pcpackrat/esp32-eth01-voter/docs/es8311.png

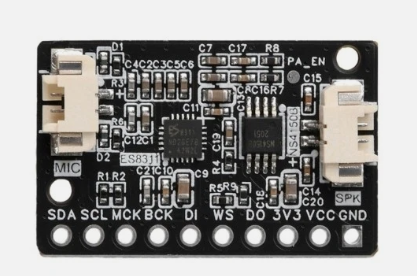
docs/es8311.png
