pcpackrat/esp32-eth01-voter/docs/cdm1250.jpg

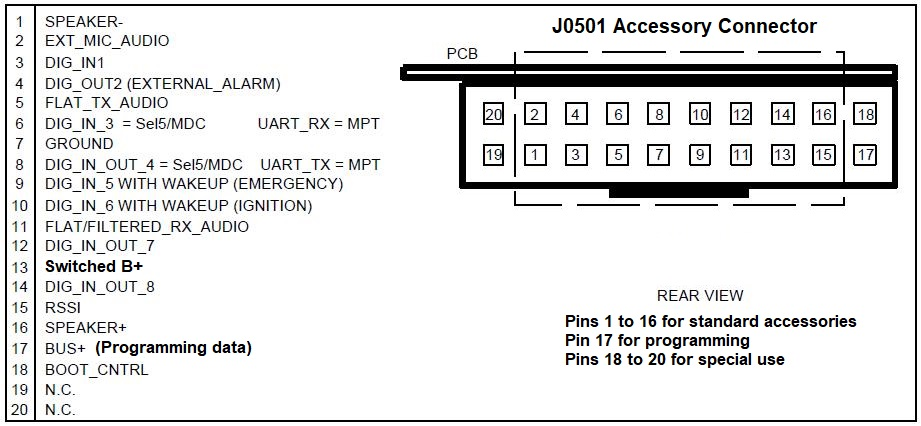
docs/cdm1250.jpg
