pcpackrat/esp32-eth01-voter/docs/GPS-Schematic.png

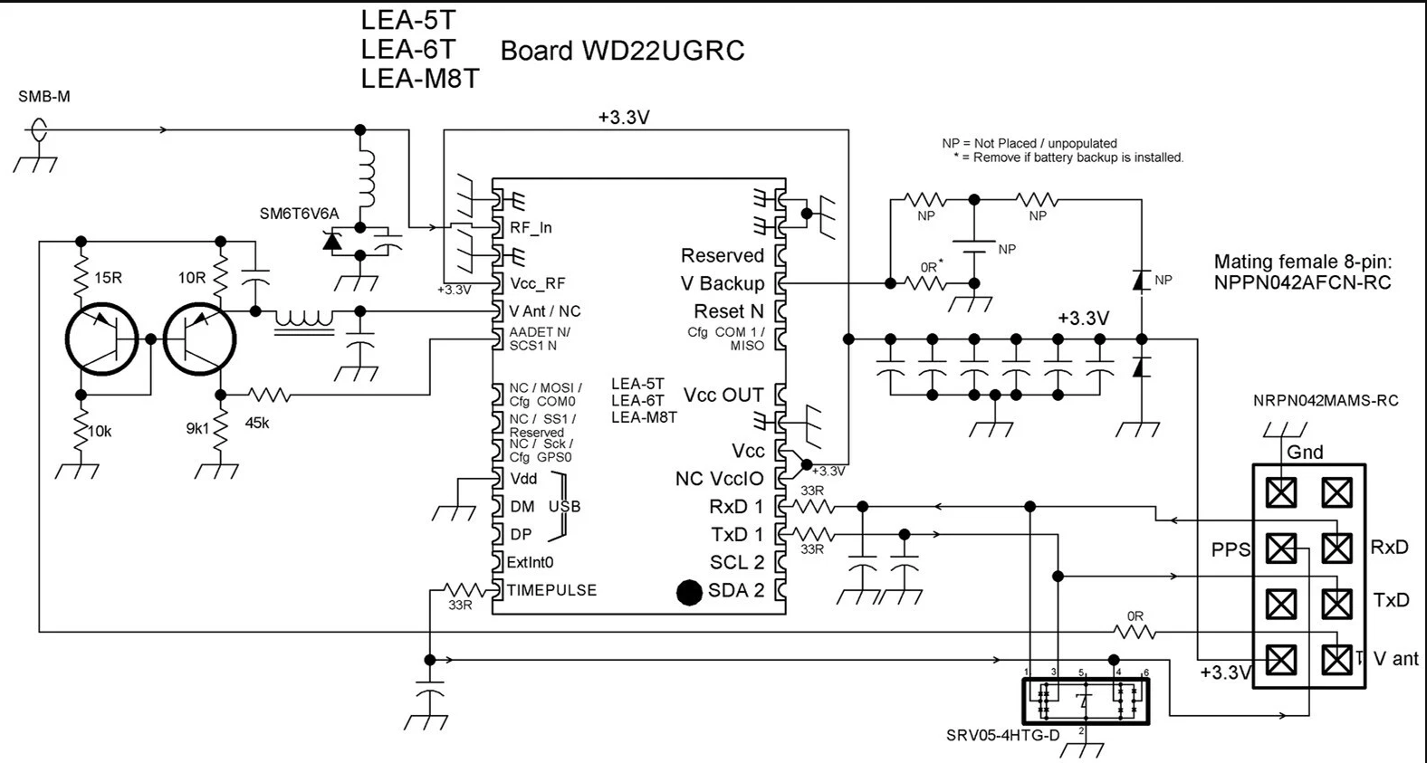
docs/GPS-Schematic.png
