pcpackrat/esp32-eth01-voter/docs/ESP32-ETH01_case.3mf

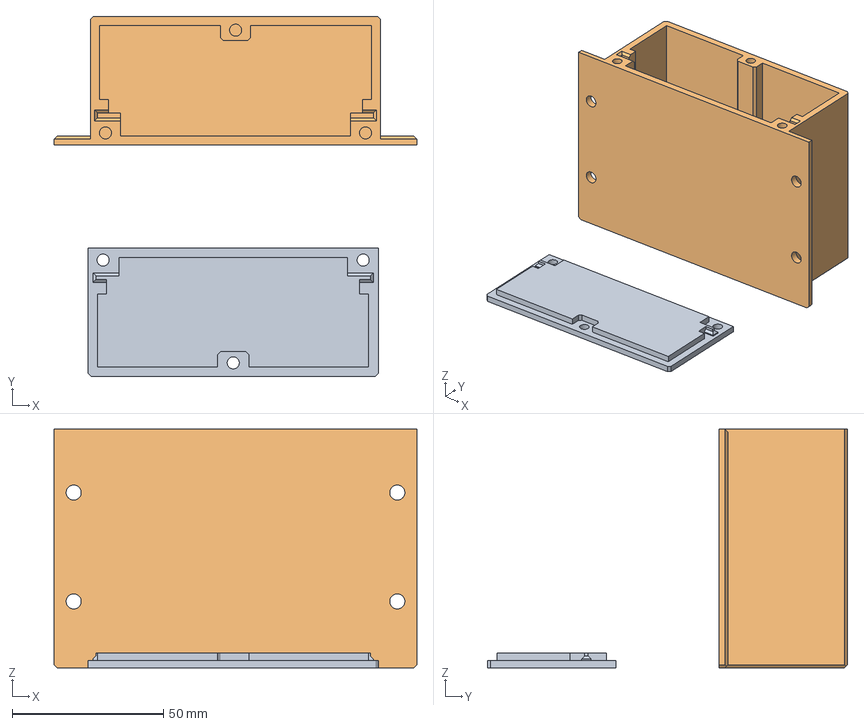
[picture p4: CAD file, 2026-11-10]
docs/ESP32-ETH01_case.3mf
120.0 x 119.0 x 79.0 mm
70x90 pcb box Blind lid.stl
Assembly
