pcpackrat/esp32-eth01-voter/src/Config.cpp

#include "Config.h"
#include "Defaults.h"
#include <Preferences.h>

ConfigManager cfg;

static Preferences prefs;

void ConfigManager::begin() {
  prefs.begin("rxvoter", false);
  size_t len = prefs.getBytesLength("cfg");
  memset(&data, 0, sizeof(data));
  if (len > 0 && len <= sizeof(data)) {
    prefs.getBytes("cfg", &data, len);
  }
  if (len >= offsetof(SysConfig, rxPgaGain) && len <= sizeof(data) &&
      data.magic == CONFIG_MAGIC && data.version >= 2 && data.version < CONFIG_VERSION) {
    // Older layouts (ESP32RXVoter v2/v3) are a prefix of this one
    uint32_t oldVersion = data.version;
    if (oldVersion < 3) {
      // Frames are now stamped with exact GPS time and the client/master
      // offsets are built in, so the stored value is only a trim
      data.timingOffsetMs = DEF_TIMING_OFFSET_MS;
      data.rxPgaGain = DEF_RX_PGA_GAIN;
      data.netIface = DEF_NET_IFACE;
      data.dspRmsNoSig = 0.0f; // DSP RSSI not calibrated
      data.dspRmsFull = 0.0f;
      data.dspSqlOpen = DEF_DSP_SQL_OPEN;
      data.dspSqlHyst = DEF_DSP_SQL_HYST;
    }
    if (oldVersion < 4) {
      data.txGainPct = DEF_TX_GAIN_PCT;
      data.pttInvert = DEF_PTT_INVERT;
      data.pttTailMs = DEF_PTT_TAIL_MS;
      data.jitterMs = DEF_JITTER_MS;
    }
    if (oldVersion < 5)
      strlcpy(data.deviceHostname, DEF_DEVICE_HOSTNAME, sizeof(data.deviceHostname));
    if (oldVersion < 6)
      data.dspBewMode = DEF_DSP_BEW_MODE;
    if (oldVersion < 7)
      data.dspNarrowBand = false;
    save();
    Serial.printf("[Config] Migrated v%lu config from NVS\r\n", (unsigned long)oldVersion);
  } else if (len != sizeof(data) || data.magic != CONFIG_MAGIC ||
             data.version != CONFIG_VERSION) {
    Serial.println("[Config] No valid config in NVS - loading defaults");
    resetDefaults();
  } else {
    Serial.println("[Config] Loaded from NVS");
  }

  if (prefs.getBytesLength("gpstm") == sizeof(gpsTm)) {
    prefs.getBytes("gpstm", &gpsTm, sizeof(gpsTm));
  } else {
    _gpsTimingDefaults();
  }

  memset(&gpsAid, 0, sizeof(gpsAid));
  // An older, shorter block leaves the newer fields at 0
  size_t aidLen = prefs.getBytesLength("gpsaid");
  if (aidLen > 0 && aidLen <= sizeof(gpsAid)) {
    prefs.getBytes("gpsaid", &gpsAid, aidLen);
  }

  // Defaults first, then whatever was saved on top (an older, shorter block
  // leaves the newer fields at their defaults)
  _rptDefaults();
  size_t rptLen = prefs.getBytesLength("rpt");
  if (rptLen > 0 && rptLen <= sizeof(rpt)) {
    prefs.getBytes("rpt", &rpt, rptLen);
  }
  _wifiNetsDefaults();
  size_t wnLen = prefs.getBytesLength("wifi");
  if (wnLen > 0 && wnLen <= sizeof(wifiNets)) {
    prefs.getBytes("wifi", &wifiNets, wnLen);
  }
  _wgDefaults();
  size_t wgLen = prefs.getBytesLength("wg");
  if (wgLen > 0 && wgLen <= sizeof(wg)) {
    prefs.getBytes("wg", &wg, wgLen);
  }
}

void ConfigManager::saveRpt() {
  prefs.putBytes("rpt", &rpt, sizeof(rpt));
  Serial.println("[Config] Repeater settings saved to NVS");
}

void ConfigManager::_rptDefaults() {
  memset(&rpt, 0, sizeof(rpt));
  rpt.enable = DEF_RPT_ENABLE;
  rpt.triggerS = DEF_RPT_TRIGGER_S;
  rpt.hangMs = DEF_RPT_HANG_MS;
  rpt.totS = DEF_RPT_TOT_S;
  rpt.gainPct = DEF_RPT_GAIN_PCT;
  rpt.deemp = DEF_RPT_DEEMP;
  rpt.courtesy = DEF_RPT_COURTESY;
  strlcpy(rpt.idCall, DEF_RPT_ID_CALL, sizeof(rpt.idCall));
  rpt.idWpm = DEF_RPT_ID_WPM;
  rpt.idFreqHz = DEF_RPT_ID_FREQ_HZ;
  rpt.idLevelPct = DEF_RPT_ID_LEVEL_PCT;
  rpt.beepHz = DEF_RPT_BEEP_HZ;
  rpt.beepMs = DEF_RPT_BEEP_MS;
  rpt.bootDelayS = DEF_RPT_BOOT_DELAY_S;
}

void ConfigManager::saveWg() {
  prefs.putBytes("wg", &wg, sizeof(wg));
  Serial.println("[Config] WireGuard settings saved to NVS");
}

void ConfigManager::_wgDefaults() {
  memset(&wg, 0, sizeof(wg));
  wg.enable = false;
  wg.endpointPort = DEF_WG_PORT;
  wg.netmask = (uint32_t)IPAddress(DEF_WG_NETMASK);
  wg.keepaliveS = DEF_WG_KEEPALIVE_S;
}

void ConfigManager::saveGpsTiming() {
  prefs.putBytes("gpstm", &gpsTm, sizeof(gpsTm));
  Serial.println("[Config] GPS timing saved to NVS");
}

void ConfigManager::saveGpsAid() {
  prefs.putBytes("gpsaid", &gpsAid, sizeof(gpsAid));
  Serial.println("[Config] GPS aiding position saved to NVS");
}

void ConfigManager::_gpsTimingDefaults() {
  memset(&gpsTm, 0, sizeof(gpsTm));
  gpsTm.mode = DEF_GPS_TMODE;
  gpsTm.svinMinDurS = DEF_SVIN_MIN_DUR_S;
  gpsTm.svinAccMm = DEF_SVIN_ACC_MM;
  gpsTm.fixedAccMm = DEF_SVIN_ACC_MM;
}

void ConfigManager::save() {
  data.magic = CONFIG_MAGIC;
  data.version = CONFIG_VERSION;
  prefs.putBytes("cfg", &data, sizeof(data));
  Serial.println("[Config] Saved to NVS");
}

void ConfigManager::resetDefaults() {
  memset(&data, 0, sizeof(data));

  // All values come from Defaults.h (site values from Site.h)

  // Voter. DEF_HOST: an IP literal sets hostIP, anything else is a hostname (as the web UI)
  IPAddress hostIp;
  if (hostIp.fromString(DEF_HOST)) {
    data.hostIP = (uint32_t)hostIp;
  } else {
    strlcpy(data.hostname, DEF_HOST, sizeof(data.hostname));
  }
  data.hostPort = DEF_HOST_PORT;
  strlcpy(data.clientPwd, DEF_CLIENT_PWD, sizeof(data.clientPwd));
  strlcpy(data.hostPwd, DEF_HOST_PWD, sizeof(data.hostPwd));
  data.timingOffsetMs = DEF_TIMING_OFFSET_MS;

  // Radio RX
  data.cosMode = DEF_COS_MODE;
  data.cosInvert = DEF_COS_INVERT;
  data.dspSquelchThresh = DEF_DSP_SQUELCH_THRESH;
  data.dspCalib = DEF_DSP_CALIB;
  data.useHwRSSI = DEF_USE_HW_RSSI;
  data.rssiMin = DEF_RSSI_MIN;
  data.rssiMax = DEF_RSSI_MAX;
  data.dspRmsNoSig = 0.0f; // DSP RSSI not calibrated
  data.dspRmsFull = 0.0f;
  data.dspSqlOpen = DEF_DSP_SQL_OPEN;
  data.dspSqlHyst = DEF_DSP_SQL_HYST;
  data.dspBewMode = DEF_DSP_BEW_MODE;
  data.dspNarrowBand = false;
  data.rxPgaGain = DEF_RX_PGA_GAIN;
  data.rxDigitalGainPct = DEF_RX_DIGITAL_GAIN_PCT;
  data.enablePLFilter = DEF_PL_FILTER;
  data.enableDeemp = DEF_DEEMPHASIS;

  // Radio TX
  data.txGainPct = DEF_TX_GAIN_PCT;
  data.pttInvert = DEF_PTT_INVERT;
  data.pttTailMs = DEF_PTT_TAIL_MS;
  data.jitterMs = DEF_JITTER_MS;

  // Network
  data.netIface = DEF_NET_IFACE;
  strlcpy(data.deviceHostname, DEF_DEVICE_HOSTNAME, sizeof(data.deviceHostname));
  data.useStaticIP = DEF_USE_STATIC_IP;
  data.staticIP = (uint32_t)IPAddress(DEF_STATIC_IP);
  data.subnetMask = (uint32_t)IPAddress(DEF_SUBNET_MASK);
  data.gateway = (uint32_t)IPAddress(DEF_GATEWAY);
  data.staticDNS = (uint32_t)IPAddress(DEF_STATIC_DNS);
  data.dnsServerIP = 0;
  strlcpy(data.wifiSSID, DEF_WIFI_SSID, sizeof(data.wifiSSID));
  strlcpy(data.wifiPass, DEF_WIFI_PASS, sizeof(data.wifiPass));

  // Syslog
  data.useSyslog = DEF_USE_SYSLOG;
  strlcpy(data.syslogHost, DEF_SYSLOG_HOST, sizeof(data.syslogHost));
  data.syslogPort = DEF_SYSLOG_PORT;

  save();
  _gpsTimingDefaults();
  saveGpsTiming();
  _rptDefaults();
  saveRpt();
  _wgDefaults();
  saveWg();
  Serial.println("[Config] Reset to defaults");
}

void ConfigManager::saveWifiNets() {
  prefs.putBytes("wifi", &wifiNets, sizeof(wifiNets));
  Serial.println("[Config] WiFi networks saved to NVS");
}

void ConfigManager::_wifiNetsDefaults() {
  memset(&wifiNets, 0, sizeof(wifiNets));
  wifiNets.pinned = WIFI_PIN_AUTO;
}

const char *ConfigManager::wifiSsid(int i) const {
  if (i == 0)
    return data.wifiSSID;
  if (i > 0 && i < WIFI_MAX_NETS)
    return wifiNets.ssid[i - 1];
  return "";
}

const char *ConfigManager::wifiPass(int i) const {
  if (i == 0)
    return data.wifiPass;
  if (i > 0 && i < WIFI_MAX_NETS)
    return wifiNets.pass[i - 1];
  return "";
}

void ConfigManager::setWifi(int i, const char *ssid, const char *pass) {
  if (i == 0) {
    strlcpy(data.wifiSSID, ssid, sizeof(data.wifiSSID));
    strlcpy(data.wifiPass, pass, sizeof(data.wifiPass));
  } else if (i > 0 && i < WIFI_MAX_NETS) {
    strlcpy(wifiNets.ssid[i - 1], ssid, sizeof(wifiNets.ssid[0]));
    strlcpy(wifiNets.pass[i - 1], pass, sizeof(wifiNets.pass[0]));
  }
}

int ConfigManager::wifiCount() const {
  int n = 0;
  for (int i = 0; i < WIFI_MAX_NETS; i++)
    if (wifiSsid(i)[0])
      n++;
  return n;
}
