pcpackrat/esp32-eth01-voter/include/GPSManager.h

#ifndef GPS_MANAGER_H
#define GPS_MANAGER_H

#include "VoterProtocol.h"
#include <Arduino.h>
#include <TinyGPSPlus.h>

class GPSManager {
public:
  GPSManager();

  // txPin -> GPS RXD, used to set up timing mode (UBX). -1 = receive only.
  void begin(HardwareSerial *port, int rxPin, int txPin, int ppsPin);

  // Main loop update (NMEA parse + lock status tracking)
  void update();

  enum GPSLockStatus {
    GPS_NO_FIX,      // No valid time yet
    GPS_LOCKED,      // Time valid, PPS active, Serial active (no satellite-count rule)
    GPS_LOST_PPS,    // Time valid, but PPS missing
    GPS_LOST_SERIAL, // Time valid, PPS active, but Serial missing
  };

  bool isLocked() { return _stableStatus == GPS_LOCKED; }
  GPSLockStatus getLockStatus() { return _stableStatus; }
  bool isTimeSet() { return _validTime; }

  // True if PPS fired since last check (clears flag). ppsTimeUs receives the
  // esp_timer time of that edge.
  bool checkPPS(int64_t *ppsTimeUs = nullptr);

  // Current network time. quantize snaps to the 20ms grid relative to PPS.
  // Safe to call from any task.
  void getNetworkTime(VTIME *t, bool quantize = true);

  uint32_t getEpoch();
  uint32_t getPpsJitter();
  void getGPSStrings(char *lat, char *lon, char *elev);
  uint32_t getSatellites() { return _gpsParser.satellites.value(); }
  void getTimestamp(char *buf); // "[HH:MM:SS.mmm]", buf >= 20 bytes

  // Activity counters - show the GPS is sending before it has a fix
  uint32_t getNmeaChars() { return _gpsParser.charsProcessed(); }
  uint32_t getNmeaGood() { return _gpsParser.passedChecksum(); }
  uint32_t getNmeaBad() { return _gpsParser.failedChecksum(); }
  int32_t getNmeaAgeMs(); // ms since the last byte, -1 = nothing received
  bool isPpsActive();     // pulse in the last 1.5 s, previous gap ~1 s

  // u-blox timing receiver state (LEA-5T), from UBX messages
  struct TimingStatus {
    bool answered;      // module replied to the CFG-TMODE poll
    uint8_t moduleMode; // as set in the module: 0 off, 1 survey-in, 2 fixed
    bool svinActive;
    bool svinValid;
    uint32_t svinDurS;
    uint32_t svinAccMm;
    bool navFresh;      // NAV-STATUS seen in the last 3 s
    uint8_t gpsFix;     // 0 none, 2 2D, 3 3D, 5 time only
    bool gpsFixOk;
  };
  TimingStatus getTimingStatus();
  // One-line timing mode summary for the status page / serial
  void timingSummary(char *buf, size_t len);

  // WGS84 conversion for showing the fixed position (ECEF in cm)
  static void ecefToLlh(int32_t x, int32_t y, int32_t z, double *latDeg, double *lonDeg, double *hM);

  // Start-up aiding: network time (UBX AID-INI) once after boot, and a GPS
  // cold start if no satellites are used for a long time.
  void coldStart(); // from the GPS web page
  void diagChanged(); // diagnostic logging switched on/off on the GPS web page
  void diagJson(char *buf, size_t len); // status page: JSON object, or null when diagnostics are off
  void aidSummary(char *buf, size_t len);

  static const char *statusStr(GPSLockStatus s);

private:
  HardwareSerial *_gpsSerial;
  TinyGPSPlus _gpsParser;
  TinyGPSCustom _gpsTxt; // $GPTXT text field: boot banner, antenna status

  // PPS state (written by ISR)
  volatile int64_t _lastPpsUs;
  volatile bool _ppsTriggered;
  volatile uint32_t _ppsPeriod;
  volatile int64_t _lastEdgeUs; // last real edge (never seeded from NMEA)

  uint32_t _lastByteMs;
  bool _gotByte;

  // Time state
  volatile uint32_t _currentEpoch;
  volatile bool _validTime;

  GPSLockStatus _stableStatus;
  GPSLockStatus _pendingStatus;
  uint32_t _pendingStartTime;
  GPSLockStatus _lastLoggedStatus;

  // UBX receive state machine
  uint8_t _ubxState;
  uint8_t _ubxClass, _ubxId;
  uint16_t _ubxLen, _ubxPos;
  uint8_t _ubxCkA, _ubxCkB;
  uint8_t _ubxBuf[208]; // largest message used: NAV-SVINFO (8 + 12 per channel, 16 channels)

  TimingStatus _tm;
  bool _canSend;
  uint32_t _lastPollMs;
  uint8_t _setCount;   // CFG-TMODE writes this boot (each one writes GPS flash)
  bool _surveySaved;
  uint32_t _navStatusMs;
  uint32_t _ubxTimeMs; // last valid NAV-TIMEUTC
  bool _ubxTimeSeen;
  uint32_t _utcFlagMs; // last NAV-TIMEUTC of any kind
  bool _utcValid;      // its validUTC flag (leap seconds known)
  bool _utcFlagLogged;

  // Aiding / cold start
  bool _aidPending;      // AID-INI still to be sent
  uint32_t _aidNotBefore; // millis() - wait after a reset before aiding
  uint32_t _aidSentMs;    // 0 = not sent this boot
  uint32_t _aidFlags;     // what the last AID-INI carried
  uint32_t _huiSentMs;    // last AID-HUI (leap seconds), 0 = not sent this boot
  bool _huiWritePending;  // AID-HUI poll sent; the readback gets the leap seconds and is written back
  uint32_t _noSatSinceMs; // start of the current no-satellite period
  uint32_t _coldWaitMs;   // no-satellite time before the next cold start
  uint8_t _coldStarts;
  uint32_t _reinitAtMs;   // after a hardware reset: re-send message config at this millis(), 0 = none

  // Diagnostics (GPS page checkbox): polled every 5 s, shown on the status page
  struct SvInfo {
    uint8_t svid, cno, state; // state: 0 signal only, 1 code locked, 2 used in fix
  };
  uint32_t _diagPollMs;   // last NAV-SVINFO / MON-HW poll
  uint32_t _svLogMs;      // last satellite report in the event log
  bool _svLogNext;        // log the next satellite report (first fix)
  SvInfo _sv[16];
  uint8_t _svCount, _svLocked, _svUsed, _svBest;
  uint32_t _svMs;         // last NAV-SVINFO, 0 = none
  uint16_t _hwNoise, _hwAgc;
  uint8_t _hwAStatus;     // 0 init, 1 don't know, 2 OK, 3 short, 4 open
  bool _antOcdSent = false; // CFG-ANT open-circuit detection written since the last message config
  uint32_t _hwMs;         // last MON-HW, 0 = none
  char _antText[16];      // last $GPTXT ANTSTATUS= value
  uint32_t _fixStartMs;   // boot (0) or last cold start
  uint32_t _ttffMs;       // time to first fix from _fixStartMs, 0 = no fix yet
  bool _fixStartCold;     // _fixStartMs is a cold start, not boot
  bool _haveFix() const { return _tm.gpsFixOk && _navStatusMs != 0 && millis() - _navStatusMs < 3000; }

  void _ubxByte(uint8_t c);
  void _sendMsgConfig();
  void _pollSettings(); // diagnostic: version + receiver settings to the event log
  bool _sendAidIni();
  void _sendAidHui();
  void _coldStart(const char *why);
  void _ubxHandle();
  void _ubxSend(uint8_t cls, uint8_t id, const uint8_t *payload, uint16_t len);
  void _pollTimeMode();
  void _sendTimeMode();
  bool _timeModeMatches(const uint8_t *p);
  void _applyTime(uint32_t gpsTime, uint32_t ageMs);

  static void _ppsISR();
  static GPSManager *_instance;

  GPSLockStatus _getRawLockStatus();
};

#endif
