pcpackrat/esp32-eth01-voter/include/App.h

#ifndef APP_H
#define APP_H

#include "GPSManager.h"
#include "GpsAudio.h"
#include "VoterClient.h"
#include <Arduino.h>

// Live status. Written by the audio tasks / loop, read by the web UI.
struct RxStatus {
  volatile uint8_t rssi;            // RSSI byte of the last frame (0 = squelched)
  volatile bool cos;                // Squelch open
  volatile uint8_t noise;           // DSP noise level (0-255)
  volatile float noiseRms;          // DSP noise RMS (Q15), the DSP RSSI input
  volatile uint8_t rssiHeldPct;     // % of the last second the DSP RSSI was held (voice)
  volatile uint16_t rssiRaw;        // RSSI pin, raw ADC counts (0-4095)
  volatile int16_t adcPeak;         // Max |sample| over last second, before DSP
  volatile int16_t encPeak;         // Max |sample| over last second, after DSP
  volatile uint32_t framesCaptured; // 20ms frames read from the codec
  volatile uint32_t framesQueued;   // Frames handed to the network send task
  volatile uint32_t framesDropped;  // Frame queue full
  volatile uint32_t readErrors;     // I2S read timeouts/errors
  volatile float clockPpm;          // Sample clock error vs GPS PPS
  volatile bool clockPpmValid;
  volatile float sendAgeAvgMs;      // GPS now - frame start, at send (last second)
  volatile float sendAgeMaxMs;

  // TX
  volatile bool ptt;               // PTT output active
  volatile uint32_t framesPlayed;  // Host audio frames written to the DAC
  volatile uint32_t writeErrors;   // I2S write errors
  volatile int16_t txPeak;         // Max |sample| over last second, to the DAC

  bool audioOk; // I2S running
  bool codecOk; // ES8311 answered and configured
};

extern RxStatus g_status;

// RSSI calibration measurement. The web UI sets it up and sets 'running';
// the RX task averages both RSSI sources and clears 'running' when done.
#define RSSI_CAL_FRAMES 250 // 5 s of 20 ms frames
struct RssiCalMeasure {
  volatile bool running;
  volatile uint16_t frames;
  uint32_t sumRaw;
  float sumRms;
  uint16_t avgRaw; // results, valid once frames == RSSI_CAL_FRAMES
  float avgRms;
};
extern RssiCalMeasure g_rssiCal;

// TX test tone, started from the Test Tone page. The TX task plays it in place
// of host audio (through TX Gain) and PTT stays keyed until untilMs.
struct TestTone {
  volatile uint16_t hz;
  volatile float amp;        // peak, 16-bit full scale = 32767
  volatile uint32_t untilMs; // millis() end time, 0 = off
};
extern TestTone g_testTone;
inline bool testToneActive() {
  uint32_t until = g_testTone.untilMs;
  return until != 0 && (int32_t)(until - millis()) > 0;
}

// Map v to RSSI 0-255, linear between the no-signal and full-quieting
// readings. Works either way round (RSSI voltage or noise falling with signal).
uint8_t rssiFromCal(float v, float atNoSig, float atFull);
void applyRadioConfig(); // apply Radio page changes without a reboot
extern GPSManager gps;
extern GpsAudio gpsAudio;
extern VoterClient voter;
extern volatile uint32_t g_rebootAt; // millis() to restart at, 0 = none
uint32_t g_adcOverruns();

// uLaw encoder clips at this magnitude (13-bit, see DSPProcessor.cpp)
#define ULAW_CLIP_LEVEL 8159

#endif
