pcpackrat/esp32-eth01-voter/include/Version.h

#ifndef VERSION_H
#define VERSION_H

#define FIRMWARE_NAME "ESP32-ETH01-Voter"
#define FIRMWARE_VERSION "0.9.0"
// Device type in exported settings files; import refuses a different type
#define DEVICE_TYPE "eth01"

// BUILD_TIMESTAMP is injected by build_timestamp.py on every build.
#ifdef BUILD_TIMESTAMP
#define BUILD_DATE BUILD_TIMESTAMP
#else
#define BUILD_DATE __DATE__ " " __TIME__
#endif

#endif
