pcpackrat/esp32-eth01-voter/include/Site.example.h

// Site settings. Copy this file to Site.h (git ignores Site.h) and edit it.
// Anything left out uses the value in Defaults.h. These are factory
// defaults only - a device that is already set up keeps its web UI settings.

// Voter host: IP address or hostname
#define DEF_HOST "10.10.10.40"
// #define DEF_HOST "voter.example.net"

#define DEF_HOST_PORT 1667
#define DEF_CLIENT_PWD "changeme" // This client's entry in voter.conf
#define DEF_HOST_PWD "changeme"   // Host password in voter.conf

// #define DEF_WIFI_SSID "MyNetwork"
// #define DEF_WIFI_PASS "MyPassword"
// #define DEF_SYSLOG_HOST "10.10.10.5"
