pcpackrat/esp32-eth01-voter/(commit log)

2026-10-24 ESP32-ETH01-Voter: full duplex voter client on WT32-ETH01 + ES8311
    Derived from ESP32RXVoter with the ESP32-P4 voter's TX path:
    - ES8311 full duplex over I2S (codec clocked from BCLK, no MCLK pin),
    DAC enabled, I2S DOUT on IO12
    - Host audio -> jitter buffer -> uLaw decode -> TX gain -> DAC
    - PTT on IO32 (header CFG), driven idle first thing at boot, with tail
    - TX settings (gain, PTT invert, tail, jitter buffer) on the Radio page,
    Transmitter card on the status page
    - Config v4 appends TX fields; same NVS layout as ESP32RXVoter, so an RX
    unit's settings carry over
    - Docs: WIRING.md TX audio pad, PTT driver, CDM pins 3/5; BUILD_PLAN.md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
    [App.h, AudioCodec.cpp, AudioCodec.h, Config.cpp, Config.h, DSPProcessor.cpp, DSPProcessor.h, Defaults.h]
2026-11-02 Leap second aiding, WireGuard, offline repeater, GPS start-up aiding
    GPS: send 18 leap seconds to the LEA-5T with UBX AID-HUI while validUTC
    is off, so time no longer waits up to 12.5 min for the satellite UTC
    data. The value is polled back and logged. Add AID-INI time and position
    aiding and automatic cold start.
    Also ports WireGuard remote access, the offline repeater, DSP RSSI voice
    hold and the host timeout from the P4 firmware. Log lines start with
    uptime.
    [App.h, Config.cpp, Config.h, DSPProcessor.cpp, DSPProcessor.h, Defaults.h, GPSManager.cpp, GPSManager.h]
2026-11-07 Client send phase delay; ES8311 module bring-up
    Clients (not host SENDALWAYS) now hold each RX frame until 30 ms after
    frame start before sending; the master still sends at ~20 ms. A client on
    the same subnet as an ESP32 master reached the host in the same ms as the
    master packet. chan_voter places client audio against the newest master
    time it has, so the drain index flipped 20 ms between frames, leaving
    empty slots (RSSI 0 linger, 20 ms dropouts). Timestamps are unchanged.
    ES8311 module: DI/DO silkscreen swapped (DI -> IO36, DO -> IO12), 32-bit
    I2S slots with x4 codec multiplier, cold power-on init retry, serial
    diag commands codec/creg/dswap.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
    [AudioCodec.cpp, AudioCodec.h, ES8311.cpp, ES8311.h, main.cpp]
2026-11-10 Settings backup/restore, multiple saved WiFi networks, PGA apply fix
    - ConfigBackup: export/import settings file, tagged with DEVICE_TYPE
    - Up to 5 saved WiFi networks, auto (strongest in range) or pinned
    - ES8311 setPgaGain verifies REG14 readback; PGA applied even after init write failure
    - VoterClient: detect host auth replies while connected
    - WebUI updates for the above
    - Docs added
    [ESP32-ETH01_case.3mf]
2026-11-11 v0.9.0: GPS reset/leap-second fixes and diagnostics, WiFi page rework
    GPS
    - Cold start is now a hardware reset (CFG-RST 0x00); message outputs
    re-sent 2 s after the module restarts
    - AID-HUI leap seconds written read-modify-write, keeping the module's
    own health/iono data; skipped when it already has UTC
    - Optional diagnostics (GPS page checkbox, saved, in backups): module
    version/settings, $GPTXT, NAKs, NAV-SVINFO and MON-HW every 5 s,
    time to first fix; GPS Diagnostics card on the Status page
    WiFi
    - Saved networks table (1-5) with Clear per network, single add/change
    form with network drop-down, scan list with signal and security
    - Save applies without reboot (reconnects only wh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
    [Config.cpp, Config.h, ConfigBackup.cpp, GPSManager.cpp, GPSManager.h, NetManager.cpp, NetManager.h, Version.h]
2026-11-12 WiFi page layout, backup timestamp, GPS aiding/antenna changes
    - WiFi page: Add/Change form first, scan results in a dropdown above SSID,
    compact saved-networks table with Edit/Clear
    - Backup file name stamped with UTC date/time (NTP, else GPS)
    - Status page: satellite signal table with column headings and legend
    - WireGuard page: Copy button for the device public key
    - GPS: start-up aiding sends network time only (position aiding removed)
    - GPS: antenna open-circuit detection enabled via CFG-ANT each boot
